maniginam/foldit/(list of files, cad)

Other CAD files:
hardware_files/right_panel.scad
