maniginam/foldit/(commit log)

2026-02-22 feat: project scaffolding with config module
    Set up FoldIt Python package structure with pyproject.toml,
    requirements, and hardware configuration (GPIO pins, servo
    calibration, camera settings, garment type definitions).
2026-02-22 feat: motor controller with servo driver and folding platform
    ServoDriver wraps GPIO PWM for angle-based servo control.
    FoldingPlatform provides high-level fold_left/right/bottom operations.
    12 tests covering duty cycle mapping, pin setup, and cleanup.
2026-02-22 feat: camera capture and image preprocessing
    CameraCapture wraps picamera2 for frame acquisition.
    ImagePreprocessor provides grayscale, threshold, and contour
    detection via OpenCV. 7 tests.
2026-02-22 feat: main robot loop orchestrating detect-classify-fold pipeline
    FoldItRobot ties together camera, preprocessor, classifier,
    and sequencer into a single process_one() pipeline. 2 tests.
2026-02-22 feat: OpenSCAD 3D models for folding robot prototype
    8 parametric models at 1:4 scale: base plate, 3 folding panels,
    hinge brackets, MG996R servo mounts, camera gantry, and full
    assembly visualization with adjustable fold angles.
    [assembly.scad, base_plate.scad, bottom_panel.scad, camera_gantry.scad, hinge_bracket.scad, left_panel.scad, right_panel.scad, servo_mount.scad]
2026-02-22 docs: bill of materials for robot prototype
    Complete BOM with electronics, mechanical hardware, 3D-printed
    parts, and optional items. Estimated total cost ~$239.
2026-02-22 refactor: add PCA9685 driver, angle validation, and error handling
    - Add ServoDriverBase ABC for dependency inversion
    - Add PCA9685ServoDriver for I2C servo control
    - Add angle range validation (0-180) to both drivers
    - Add graceful error handling in main loop
    - Add zero-area contour check in classifier
    - 71 tests passing (39 new tests added)
    [classifier.py, main.py, motor_controller.py, test_camera.py, test_classifier.py, test_main.py, test_motor_controller.py]
2026-02-22 fix: correct OpenSCAD alignment, tolerances, and print guidance
    - Fix hinge bracket hole alignment with base plate (was 5mm off)
    - Fix assembly.scad bracket positioning errors
    - Upgrade servo mount screw holes from M3 to M4 for MG996R tabs
    - Add print guidance notes for camera gantry and base plate
    - Parameterize remaining magic numbers
    [assembly.scad, base_plate.scad, bottom_panel.scad, camera_gantry.scad, hinge_bracket.scad, servo_mount.scad]
2026-02-22 docs: wiring diagram and full-scale prototype design
    - Wiring schematic with ASCII art, connection table, power budget
    - Full-scale design: aluminum frame, DS3225 servos, plywood panels
    - Estimated full-scale BOM ~$382
2026-02-22 feat: Pi deployment scripts and hardware verification
    - setup_pi.sh: automated Pi setup (I2C, camera, venv, systemd)
    - verify_hardware.py: test I2C, servo sweep, camera capture
    - Deploy README with troubleshooting guide
2026-02-22 feat: calibration tooling with CLI for servos and camera
    - CalibrationStore: JSON config persistence
    - ServoCalibrator: interactive per-channel angle calibration
    - CameraCalibrator: capture, detect, classify, annotate
    - CalibrationCLI: subcommands (servos, camera, test)
    - 21 tests with full dependency injection
2026-02-23 docs: v2 design and implementation plan
    Design for 5 improvements: conveyor separation, ML classification,
    adaptive thresholding, wrinkle handling, multi-item detection.
2026-02-23 feat: multi-item detection with count and filtering
    ItemDetector finds all garments on platform, returns count and
    largest contour. Filters by minimum area threshold. 5 tests.
2026-02-23 feat: flatness checker using contour solidity
    FlatnessChecker computes solidity (area/hull_area) to detect
    bunched-up garments that need pre-flattening. 5 tests.
2026-02-23 feat: ML classifier with MobileNetV2 TFLite and hybrid fallback
    MLClassifier wraps TFLite inference. HybridClassifier tries ML
    first, falls back to heuristic on low confidence or errors.
    Includes training script for desktop. 7 tests.
    [ml_classifier.py, test_ml_classifier.py]
2026-02-23 feat: conveyor controller with ultrasonic sensor and motor driver
    ConveyorMotor drives belt via L298N. UltrasonicSensor detects
    garments entering fold zone. ConveyorController orchestrates
    advance-and-stop flow. 8 tests.
2026-02-23 feat: FoldItRobotV2 with full intelligent pipeline
    V2 loop: conveyor feeds garment -> multi-item check -> flatness
    check with pre-flatten -> classify -> fold. 3 tests.
    Total project: 106 tests passing.
2026-02-23 docs: update hardware docs with conveyor belt components
    Add L298N motor driver, HC-SR04 ultrasonic sensor, DC gear motor,
    belt/rollers to BOM ($260.80 total), wiring diagram, connection table,
    power budget, full-scale design, and README. Include voltage divider
    safety note for HC-SR04 Echo pin.
2026-02-23 feat: add conveyor OpenSCAD models at 1:4 scale
    Create belt_frame.scad (conveyor frame with roller axle holes and
    mounting tabs), motor_mount_conv.scad (N20 DC motor cradle bracket),
    sensor_bracket.scad (HC-SR04 L-bracket with tilt angle). Update
    assembly.scad with conveyor positioning at front intake edge.
    [assembly.scad, belt_frame.scad, motor_mount_conv.scad, sensor_bracket.scad]
2026-02-23 feat: add tflite-runtime, RPi.GPIO, and conveyor hardware verification
    Update setup_pi.sh with tflite-runtime and RPi.GPIO dependencies.
    Add test_ultrasonic() and test_conveyor_motor() to verify_hardware.py
    with timeout protection and GPIO cleanup.
2026-02-23 feat: simulator mode for hardware-free development
    Add SimulatedCamera (synthetic garment frames), SimulatedServoDriver
    (extends ServoDriverBase with logging), SimulatedConveyor (always
    detects), and create_simulated_robot() factory. Add --simulate CLI
    flag to main.py. 12 new tests, 118 total passing.
2026-02-23 feat: error recovery with retry logic and state tracking
    [error_recovery.py, test_error_recovery.py]
2026-02-23 feat: V3 simulator factory and --items CLI flag
    Add create_simulated_robot_v3() factory to simulator.py that wires up
    all V3 support objects (orientation, size estimator, fold verifier,
    error recovery, metrics, logger, data collector) alongside the V2 robot.
    Update main() to use the V3 factory and add --items flag for processing
    multiple garments in simulate mode.
    [main.py, simulator.py]
2026-02-23 docs: V4 enhancements design — pipeline composition, ML training, vision quality, metrics persistence
2026-02-23 docs: V4 implementation plan — 12 tasks, 53 new tests, TDD
2026-02-23 feat: pre-classification frame quality checker
2026-02-23 feat: automatic camera calibration using reference object
2026-02-23 feat: failure pattern alerter with consecutive and rate rules
    [alerter.py, test_alerter.py]
2026-02-23 feat: add frame_quality, alerting, metrics_store config sections
2026-02-23 docs: V5 improvements design — production hardening, observability, ML integration, DX
2026-02-23 docs: V5 implementation plan — 12 tasks, 43 new tests, TDD
2026-02-23 feat: thread-safe SSE event stream
2026-02-23 feat: webhook alert notifier for failure patterns
    [alert_notifier.py, test_alert_notifier.py]
2026-02-23 feat: data augmentation with rotation, flip, brightness jitter
    [test_augmentation.py]
2026-02-23 feat: wire HybridClassifier into V3 pipeline with unified interface
    Unify classifier interface so classify(contour, frame=None) is the
    standard signature. GarmentClassifier drops @staticmethod, HybridClassifier
    swaps arg order, and V3 pipeline passes frame to classifier. All callers
    and tests updated.
    [calibration.py, classifier.py, main.py, ml_classifier.py, test_classifier.py, test_ml_classifier.py, test_ml_integration.py, test_v3_pipeline.py]
